Samatthe/Freqy-Lights/Case Design/Freqy Lights Top.stl

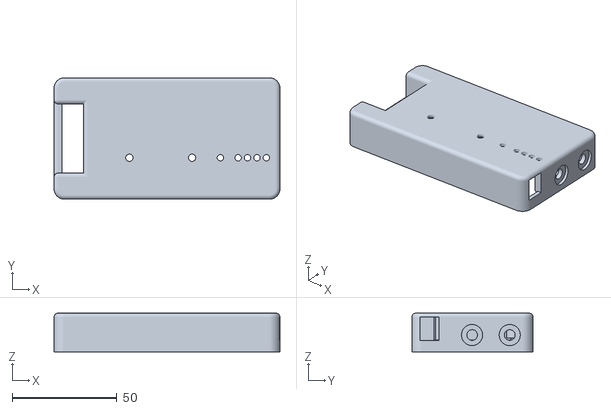
[picture p1: CAD file, 2015-09-16]
Case Design/Freqy Lights Top.stl
108.0 x 58.0 x 18.6
