Samatthe/Freqy-Lights/Case Design/Freqy Lights Bottom.stl

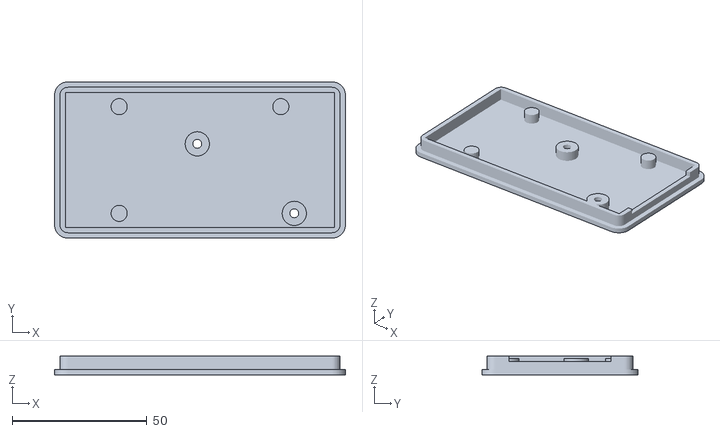
[picture p2: CAD file, 2015-09-16]
Case Design/Freqy Lights Bottom.stl
108.0 x 58.0 x 6.90
