Samatthe/Freqy-Lights/(list of files, cad)

Other CAD files:
Case Design/Freqy Lights Bottom.CATPart
Case Design/Freqy Lights Top.CATPart
