Samatthe/Freqy-Lights/PCB Design/Freqy Lights 1v1.brd

## EAGLE design PCB Design/Freqy Lights 1v1.brd (2015-09-28)

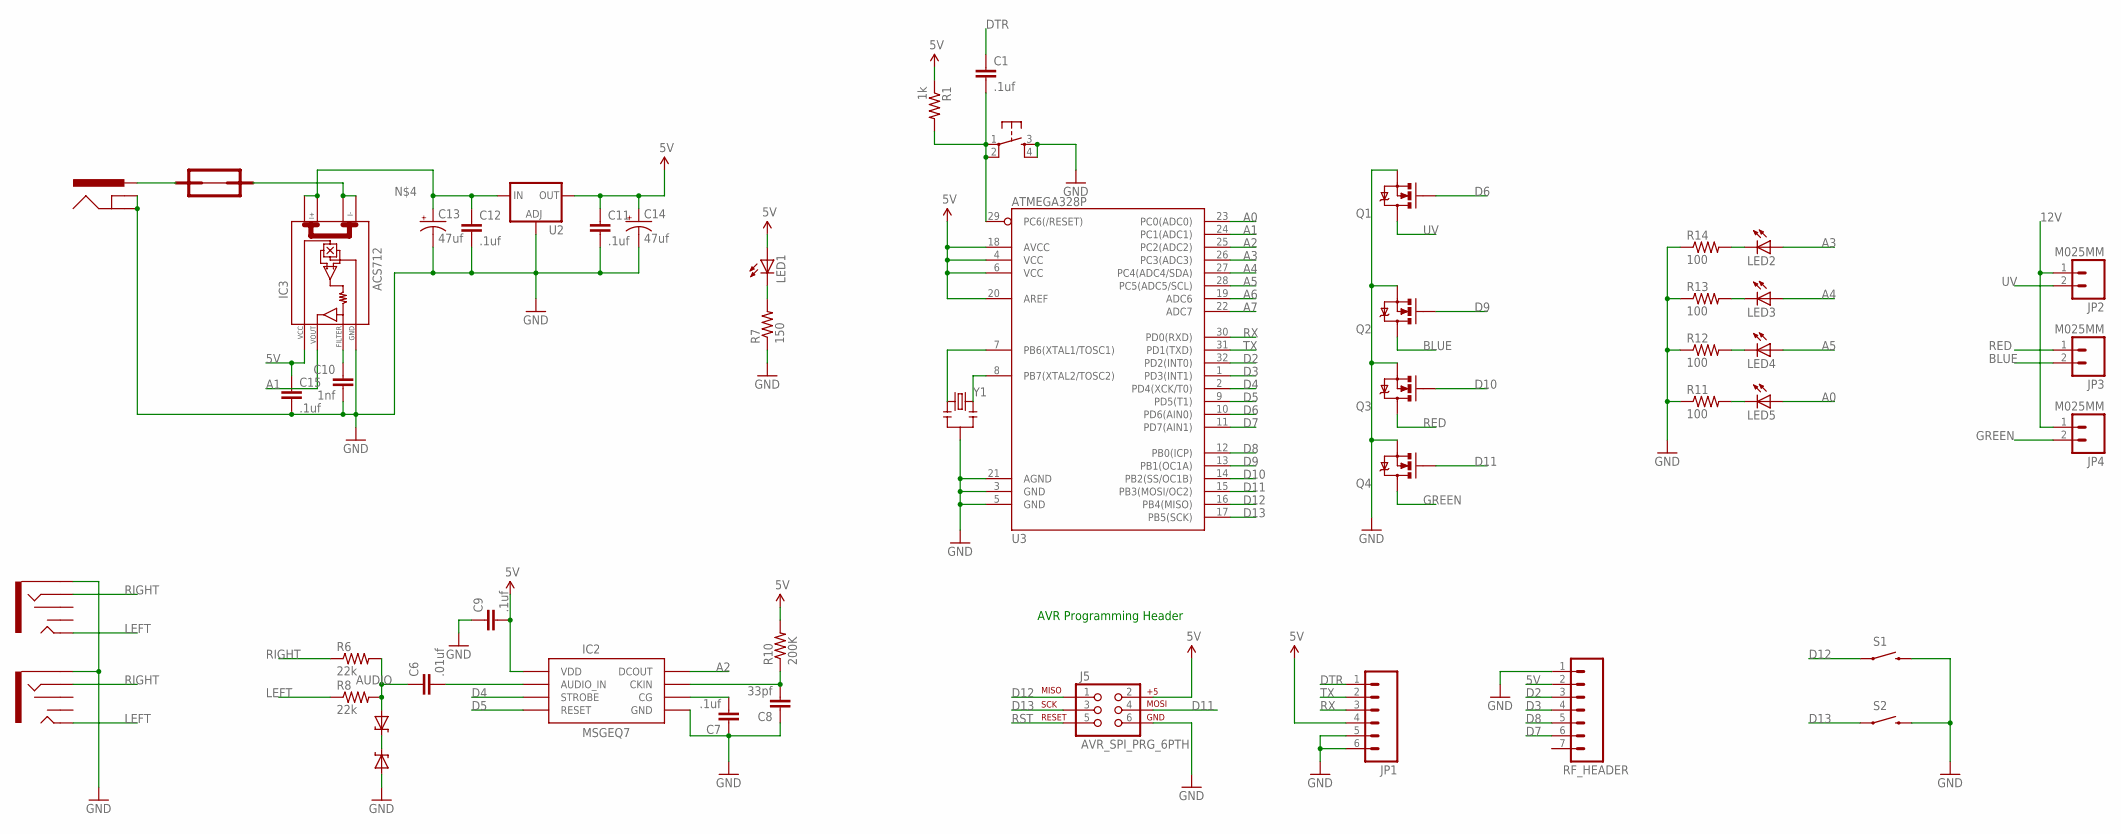
[picture p3: schematic Freqy Lights 1v1.sch]

Parts:
AJ1, AJ2: SC1488-1-ND_SMD_AUDIO_3.5; 3.5MM_SMD_AUDIO_SC1488-1-ND
BJ1: CP-202BH-ND_POWERJACK; POWER_JACK_CP-202BH-ND
C1, C7, C9, C11, C12, C15: .1uf; 1206
C6: .01uf; 1206
C8: 33pf; 1206
C10: 1nf; 1206
C13, C14: 47uf; SMD_47UF_CAP_493-2202-1-ND
F1: SSQ12
IC2: MSGEQ7SOIC; SOIC8
IC3: ACS712; SO08
J5: AVR_SPI_PRG_6PTH; 2X3
JP1: M06SIP; 1X06
JP2, JP3, JP4: M025MM; SCREWTERMINAL-5MM-2
LED1, LED2, LED3, LED4, LED5: LED1206; LED-1206
P1: CKN9085CT-ND_SMT_PUSHBUTTON; SMT_PUSHBUTTON_CKN9085CT-ND
Q1, Q2, Q3, Q4: MOSFET-NCHANNELBSS138; SOT23
R1: 1k; 1206
R6, R8: 22k; 1206
R7: 150; 1206
R10: 200K; 1206
R11, R12, R13, R14: 100; 1206
RF_HEADER: M07; 1X07
S1, S2: SWITCH-MOMENTARY-2PTH; TACTILE-PTH
U2: V_REG_317SMD; SOT223
U3: ATMEGA328P; TQFP32-08
U$10, U$11: MM3Z3V3ST1GOSCT-ND_3V_DIODE; 3V_DIODE_MM3Z3V3ST1GOSCT-ND
Y1: RESONATORPTH; RESONATOR-PTH

Connections:
5V: C9.2, C11.1, C14.P$2 (+), C15.1, IC2.1 (VDD), IC3.8 (VCC), J5.2, JP1.4, LED1.A, R1.1, R10.2, RF_HEADER.2, U2.2 (OUT), U3.4 (VCC), U3.6 (VCC), U3.18 (AVCC), U3.20 (AREF)
12V: C12.1, C13.P$2 (+), IC3.1 (I+_0), IC3.2 (I+_1), JP2.1, JP4.1, U2.3 (IN)
A0: LED5.A, U3.23 (PC0(ADC0))
A1: IC3.7 (VOUT), U3.24 (PC1(ADC1))
A2: IC2.3 (DCOUT), U3.25 (PC2(ADC2))
A3: LED2.A, U3.26 (PC3(ADC3))
A4: LED3.A, U3.27 (PC4(ADC4/SDA))
A5: LED4.A, U3.28 (PC5(ADC5/SCL))
A6: U3.19 (ADC6)
A7: U3.22 (ADC7)
AUDIO: C6.1, R6.2, R8.2, U$11.P$2 (A)
BLUE: JP3.2, Q2.3 (D)
D2: RF_HEADER.3, U3.32 (PD2(INT0))
D3: RF_HEADER.4, U3.1 (PD3(INT1))
D4: IC2.4 (STROBE), U3.2 (PD4(XCK/T0))
D5: IC2.7 (RESET), U3.9 (PD5(T1))
D6: Q1.1 (G), U3.10 (PD6(AIN0))
D7: RF_HEADER.6, U3.11 (PD7(AIN1))
D8: RF_HEADER.5, U3.12 (PB0(ICP))
D9: Q2.1 (G), U3.13 (PB1(OC1A))
D10: Q3.1 (G), U3.14 (PB2(SS/OC1B))
D11: J5.4, Q4.1 (G), U3.15 (PB3(MOSI/OC2))
D12: J5.1, S1.1, U3.16 (PB4(MISO))
D13: J5.3, S2.1, U3.17 (PB5(SCK))
DTR: C1.1, JP1.1
GND: AJ1.RING, AJ2.RING, BJ1.GND, BJ1.GNDBRK (GNDBREAK), C7.1, C8.1, C9.1, C10.2, C11.2, C12.2, C13.P$1 (-), C14.P$1 (-), C15.2, IC2.2 (GND), IC3.5 (GND), J5.6, JP1.5, JP1.6, P1.3, P1.4, Q1.2 (S), Q2.2 (S), Q3.2 (S), Q4.2 (S), R7.1, R11.1, R12.1, R13.1, R14.1, RF_HEADER.1, S1.3 (2), S2.3 (2), U2.1 (ADJ), U3.3 (GND), U3.5 (GND), U3.21 (AGND), U$10.P$2 (A), Y1.2
GREEN: JP4.2, Q4.3 (D)
LEFT: AJ1.TIP, AJ2.TIP, R8.1
unnamed: U$10.P$1 (C), U$11.P$1 (C)
unnamed: F1.P$2, IC3.3 (I-_0), IC3.4 (I-_1)
unnamed: C7.2, IC2.6 (CG)
unnamed: C6.2, IC2.5 (AUDIO_IN)
unnamed: LED1.C, R7.2
unnamed: C8.2, IC2.8 (CKIN), R10.1
unnamed: U3.7 (PB6(XTAL1/TOSC1)), Y1.1
unnamed: U3.8 (PB7(XTAL2/TOSC2)), Y1.3
unnamed: C10.1, IC3.6 (FILTER)
unnamed: LED5.C, R11.2
unnamed: LED4.C, R12.2
unnamed: LED3.C, R13.2
unnamed: LED2.C, R14.2
unnamed: BJ1.PWR, F1.P$1
RED: JP3.1, Q3.3 (D)
RIGHT: AJ1.SLEEVE, AJ2.SLEEVE, R6.1
RST: C1.2, J5.5, P1.1, P1.2, R1.2, U3.29 (PC6(/RESET))
RX: JP1.3, U3.30 (PD0(RXD))
TX: JP1.2, U3.31 (PD1(TXD))
UV: JP2.2, Q1.3 (D)

Notes on the sheet:
AVR Programming Header

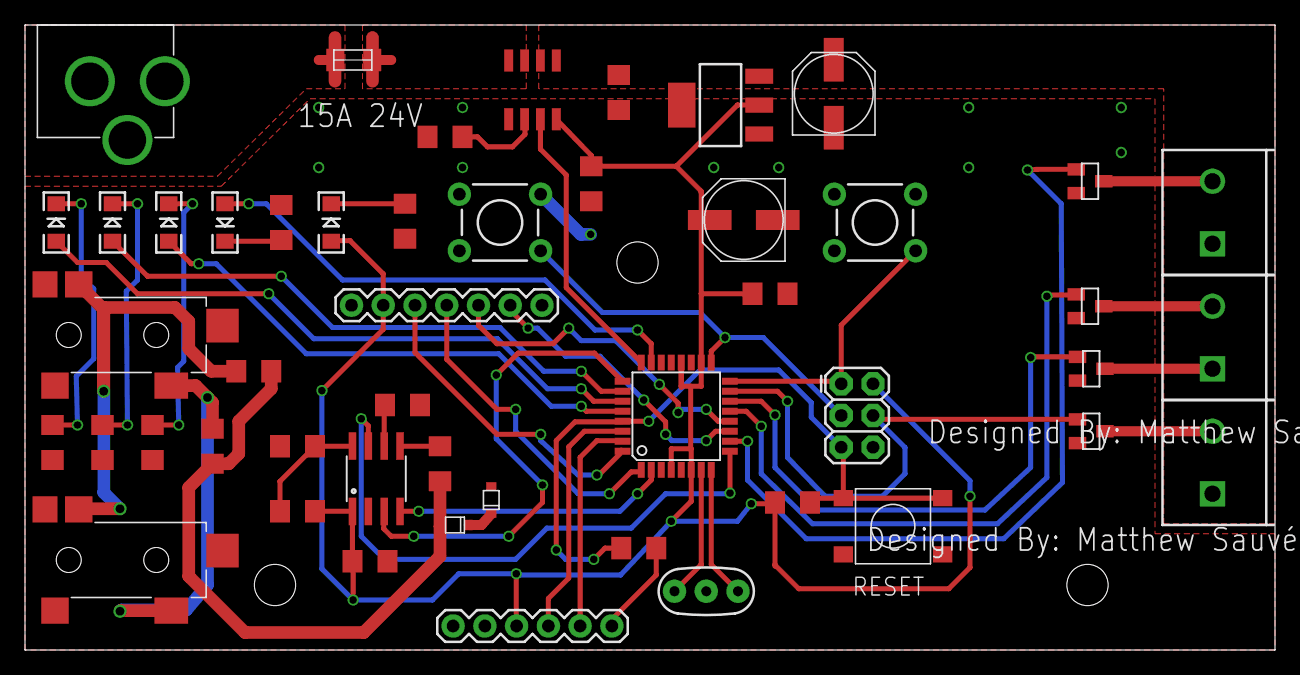
[picture p4: board Freqy Lights 1v1.brd from above]

Board: 2 copper layers, 100.0 x 50.0 mm, 52 parts (0 on the bottom side), 46 nets.

Other parts of the board:
U$1, U$2, U$3: STAND-OFF
