Samatthe/Freqy-Lights/(commit log)

2015-09-14 First Commit
    Added current program files to repo
2015-09-14 Revert "small changes"
    This reverts commit ffb5228675db3089b34a67db65559ac9c630ec0b.
    [Freqy_Lights.ino]
2015-09-14 Revert "Revert "small changes""
    This reverts commit ba1f35737dd586a3ee2f63c0124c4f8079821f75.
    [Freqy_Lights.ino]
2015-09-16 added case design files
    [Freqy Lights Bottom.CATPart, Freqy Lights Bottom.stl, Freqy Lights Top - With Remote.CATPart, Freqy Lights Top - With Remote.stl]
2015-09-16 changed file names for case top
    [Freqy Lights Top.CATPart, Freqy Lights Top.stl]
2015-09-28 added Eagle files to repo
    [Freqy Lights 1v1.brd, Freqy Lights 1v1.sch]
